theacodes/model-m/hardware/motherboard/motherboard.kicad_pcb

## KiCad design hardware/motherboard/motherboard.kicad_pcb (2019-12-20)

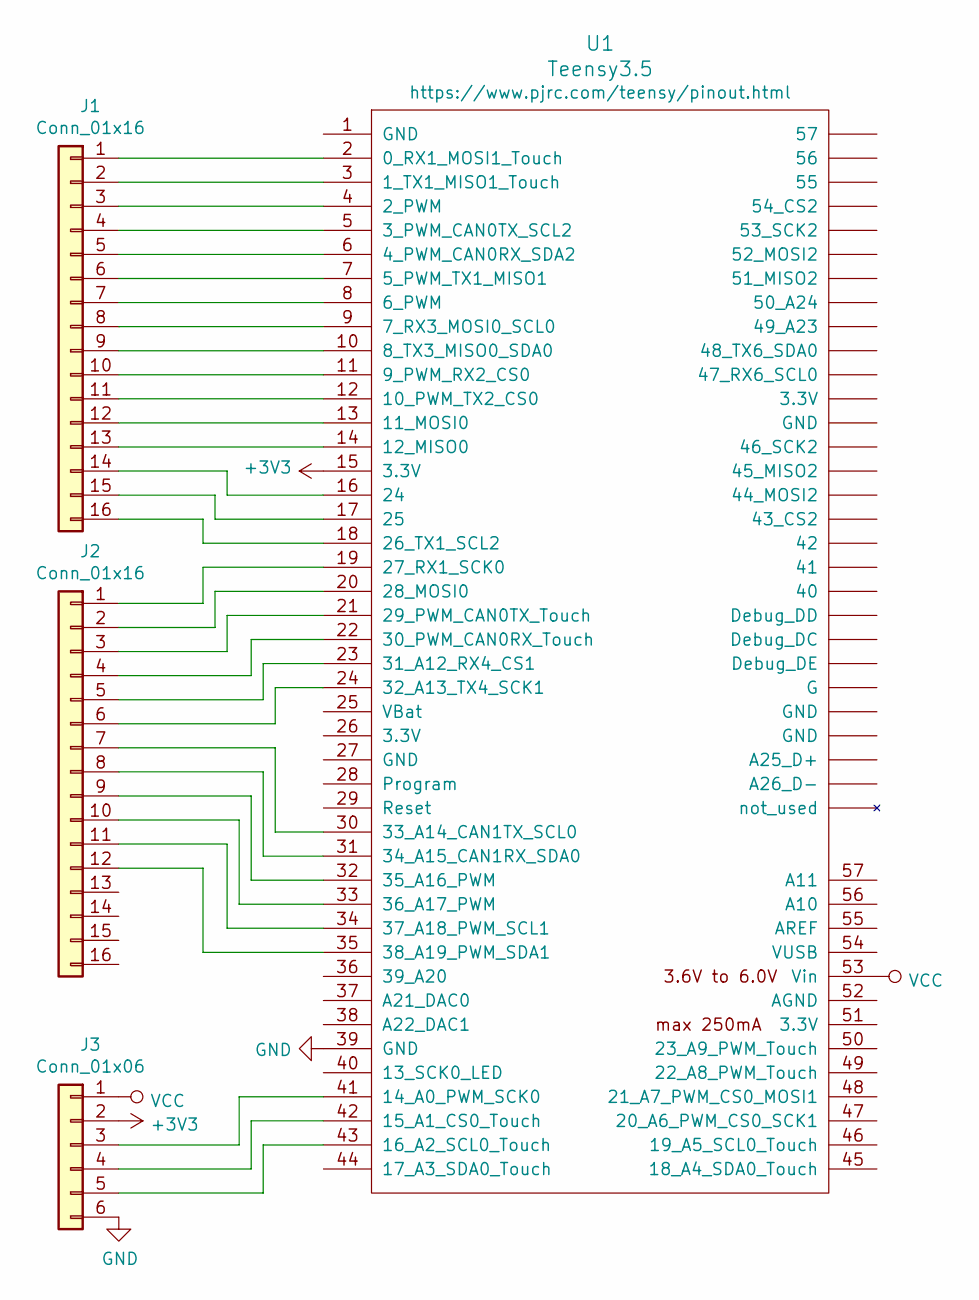
[picture p1: schematic motherboard.sch]

Parts:
J1, J2: Conn_01x16; 1X16_LONGPADS
J3: Conn_01x06; 1X06_LONGPADS
U1: Teensy3.5; Teensy35_36

Connections:
+3V3: J3.2, U1.15 (3.3V)
GND: J3.6, U1.39 (GND)
unnamed: J1.1, U1.2 (0_RX1_MOSI1_Touch)
unnamed: J1.2, U1.3 (1_TX1_MISO1_Touch)
unnamed: J1.3, U1.4 (2_PWM)
unnamed: J1.4, U1.5 (3_PWM_CAN0TX_SCL2)
unnamed: J1.5, U1.6 (4_PWM_CAN0RX_SDA2)
unnamed: J1.6, U1.7 (5_PWM_TX1_MISO1)
unnamed: J1.7, U1.8 (6_PWM)
unnamed: J1.8, U1.9 (7_RX3_MOSI0_SCL0)
unnamed: J1.9, U1.10 (8_TX3_MISO0_SDA0)
unnamed: J1.10, U1.11 (9_PWM_RX2_CS0)
unnamed: J1.11, U1.12 (10_PWM_TX2_CS0)
unnamed: J1.12, U1.13 (11_MOSI0)
unnamed: J1.13, U1.14 (12_MISO0)
unnamed: J1.14, U1.16 (24)
unnamed: J1.15, U1.17 (25)
unnamed: J1.16, U1.18 (26_TX1_SCL2)
unnamed: J2.1, U1.19 (27_RX1_SCK0)
unnamed: J2.2, U1.20 (28_MOSI0)
unnamed: J2.3, U1.21 (29_PWM_CAN0TX_Touch)
unnamed: J2.4, U1.22 (30_PWM_CAN0RX_Touch)
unnamed: J2.5, U1.23 (31_A12_RX4_CS1)
unnamed: J2.6, U1.24 (32_A13_TX4_SCK1)
unnamed: J2.7, U1.30 (33_A14_CAN1TX_SCL0)
unnamed: J2.8, U1.31 (34_A15_CAN1RX_SDA0)
unnamed: J2.9, U1.32 (35_A16_PWM)
unnamed: J2.10, U1.33 (36_A17_PWM)
unnamed: J2.11, U1.34 (37_A18_PWM_SCL1)
unnamed: J2.12, U1.35 (38_A19_PWM_SDA1)
unnamed: J3.3, U1.41 (14_A0_PWM_SCK0)
unnamed: J3.4, U1.42 (15_A1_CS0_Touch)
unnamed: J3.5, U1.43 (16_A2_SCL0_Touch)
VCC: J3.1, U1.53 (Vin)

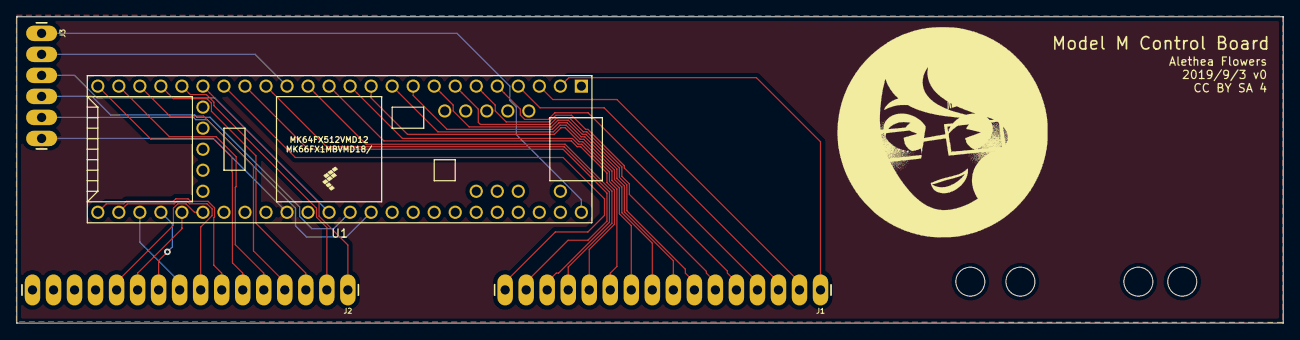
[picture p2: board motherboard.kicad_pcb from above]

Board: 2 copper layers, 153.0 x 37.0 mm, 5 parts (0 on the bottom side), 34 nets.

Other parts of the board:
e: MountingHole_3.5mm
