theacodes/model-m/hardware/led_daughterboard/led_daughterboard.kicad_pcb

## KiCad design hardware/led_daughterboard/led_daughterboard.kicad_pcb (2019-12-20)

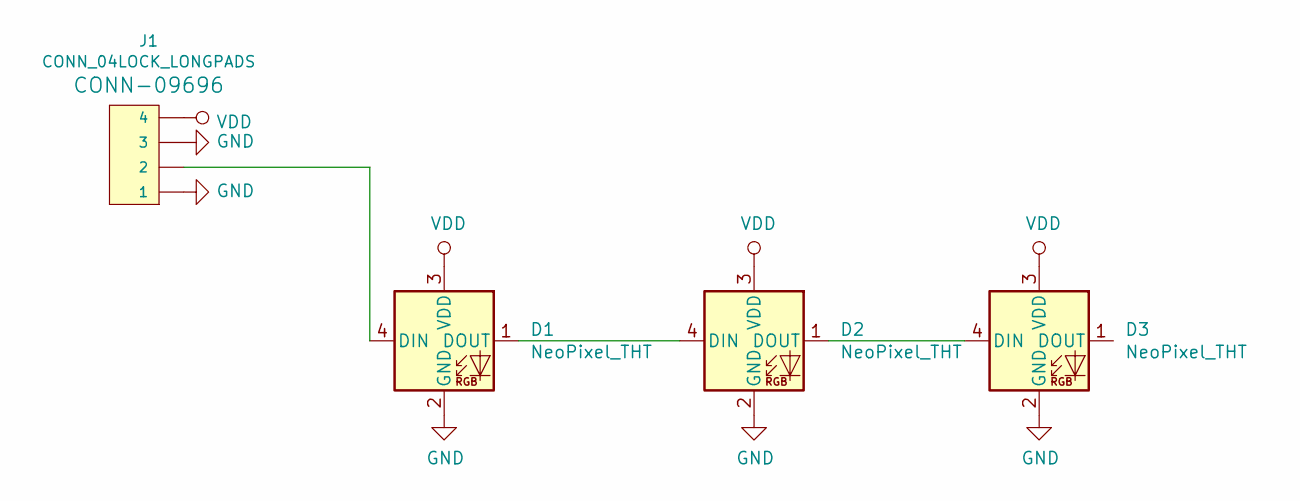
[picture p3: schematic led_daughterboard.sch]

Parts:
D1, D2, D3: NeoPixel_THT; LED_D5.0mm-4_RGB
J1: CONN_04LOCK_LONGPADS; 1X04_LOCK_LONGPADS

Connections:
GND: D1.2 (GND), D2.2 (GND), D3.2 (GND), J1.1, J1.3
unnamed: D1.1 (DOUT), D2.4 (DIN)
unnamed: D1.4 (DIN), J1.2
unnamed: D2.1 (DOUT), D3.4 (DIN)
VDD: D1.3 (VDD), D2.3 (VDD), D3.3 (VDD), J1.4

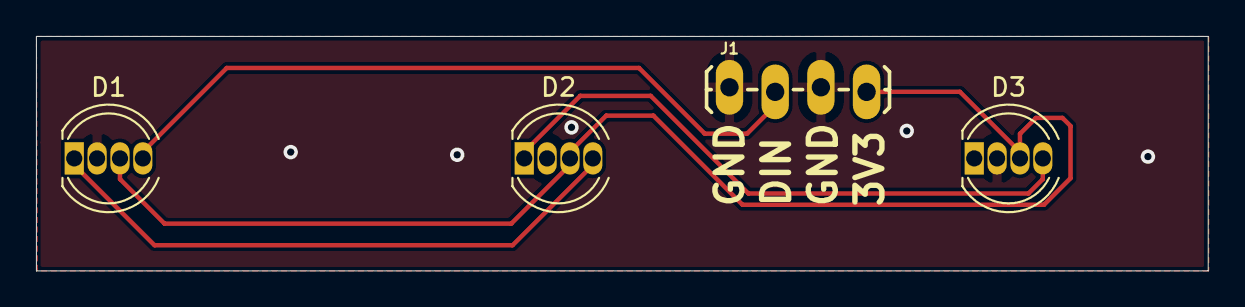
[picture p4: board led_daughterboard.kicad_pcb from above]

Board: 2 copper layers, 65.1 x 13.0 mm, 4 parts (0 on the bottom side), 5 nets.
