theacodes/model-m/(notices)

Notices in the files:
hardware/led_daughterboard/led_daughterboard.kicad_pcb:
CC-BY-SA 4.0
hardware/motherboard/motherboard.kicad_pcb:
CC BY SA 4
